tsukasaJapan9/inchworm_robot/stl/inchworm_body.stl

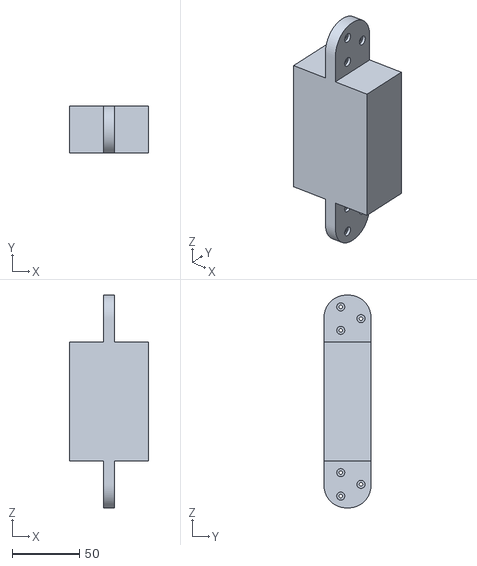
[picture p1: CAD file, 2026-10-27]
stl/inchworm_body.stl
58.4 x 35.0 x 157.8
