tsukasaJapan9/inchworm_robot/stl/inchworm_leg.stl

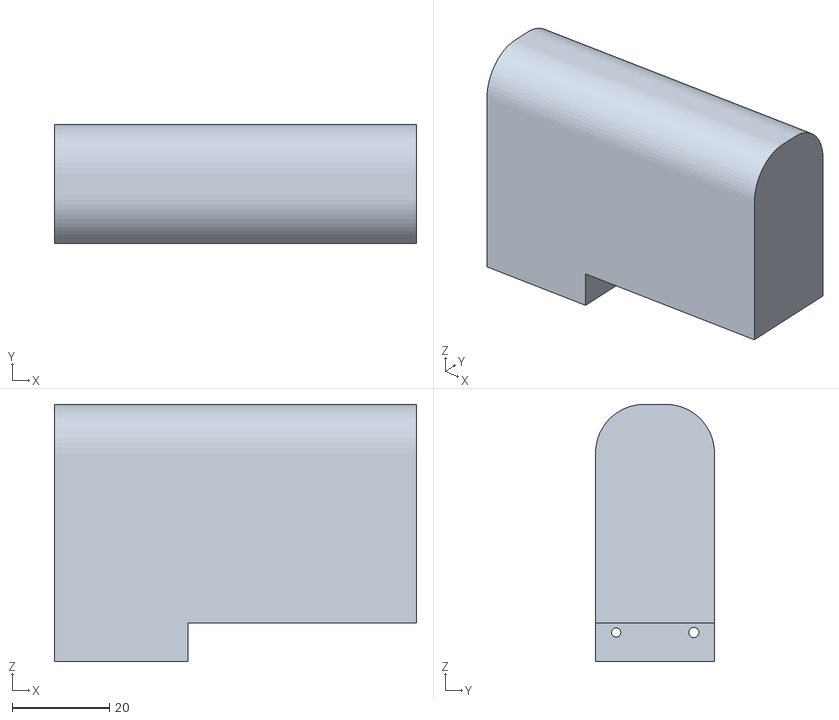
[picture p2: CAD file, 2026-10-27]
stl/inchworm_leg.stl
74.6 x 24.5 x 53.0
