tsukasaJapan9/inchworm_robot/firmware/include/policy_weights_best.h

// ppo_raw_s0 から自動生成。手で編集しないこと。
// 生成: export_policy.py
//
// 方策: 14 -> Tanh(64) -> Tanh(64) -> 2（決定論的に平均を使う）
// 観測の並び:
//   [0:3]   重力方向（機体座標・単位ベクトル）
//   [3:6]   角速度 [rad/s]（機体座標）
//   [6:8]   関節角 q1, q2 [rad]（水平が 0、持ち上げる向きが正）
//   [8:10]  関節角速度 [rad/s]
//   [10:12] 前回の行動（[-1,1]）
//   [12:14] いまの目標角 / 90deg
// 行動: 目標角の増分。a * 5.0deg を毎制御ステップ積分する

#pragma once

#define POLICY_N_IN 14
#define POLICY_N_HIDDEN 64
#define POLICY_N_OUT 2
#define POLICY_DELTA_MAX_DEG 5.0000f
#define POLICY_Q_MAX_DEG 90.0f
#define POLICY_CLIP_OBS 10.0f
#define POLICY_CTRL_HZ 100

static const float kObsMean[14] = {
    +0.00000000e+00f, +0.00000000e+00f, +0.00000000e+00f, +0.00000000e+00f,
    +0.00000000e+00f, +0.00000000e+00f, -5.91512382e-01f, -4.76291269e-01f,
    -4.85463068e-02f, +1.17681306e-02f, -5.83386198e-02f, -4.46531288e-02f,
    -4.03800994e-01f, -3.29097480e-01f};

static const float kObsStd[14] = {
    +1.00000000e+00f, +1.00000000e+00f, +1.00000000e+00f, +1.00000000e+00f,
    +1.00000000e+00f, +1.00000000e+00f, +6.33301079e-01f, +6.48618698e-01f,
    +7.84442616e+00f, +7.57599163e+00f, +9.62690532e-01f, +9.31985021e-01f,
    +4.01620507e-01f, +4.12158936e-01f};

static const float kW0[896] = {
    -1.24998808e-01f, -3.48368287e-01f, +2.54038721e-03f, -5.79545721e-02f,
    +1.56321332e-01f, -2.43111193e-01f, +6.03758514e-01f, -1.51515573e-01f,
    -1.73486724e-01f, -1.02083594e-01f, +9.16817114e-02f, -5.17216809e-02f,
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
    +1.09459020e-01f, -3.47710736e-02f, -1.53051883e-01f, +1.21875972e-01f,
    +1.44052774e-01f, -1.64233685e-01f, -1.15037046e-01f, -2.70267487e-01f,
    -1.04568750e-02f, -1.31727621e-01f, +2.78664418e-02f, -3.38132158e-02f,
    -1.33103892e-01f, -7.86769539e-02f, -1.07549906e-01f, -1.26556888e-01f,
    +6.03140779e-02f, +1.45445287e-01f, -1.31578997e-01f, +1.09187342e-01f,
    -5.55461319e-03f, -1.35907263e-01f, -1.05529487e-01f, +1.73909307e-01f,
    -3.03140935e-02f, +2.09814636e-03f, -6.65227026e-02f, +2.42546108e-02f,
    +9.35731530e-02f, -1.61508769e-01f, +1.27376122e-02f, -8.76836106e-02f,
    +5.12226252e-03f, -6.48401603e-02f, +1.70342416e-01f, +1.41291348e-02f,
    +5.56773618e-02f, -6.68664202e-02f, -2.03340709e-01f, +1.12306334e-01f,
    -1.22746937e-01f, -1.50332242e-01f, -1.55354798e-01f, +2.31487021e-01f,
    +1.61886454e-01f, -7.67782237e-03f, +1.92244679e-01f, -7.43495300e-02f,
    +1.60949409e-01f, +5.49658425e-02f, +3.69816162e-02f, -3.58987004e-02f,
    -5.55724055e-02f, -2.86081079e-02f, -1.68594837e-01f, -2.54996703e-03f};

static const float kB2[2] = {+3.69302463e-03f, -1.19649647e-02f};
