tsukasaJapan9/inchworm_robot/(commit log)

2026-10-27 ロボットのソースコード一式を追加
2026-10-27 stlデータを追加 (#2)
    [inchworm_body.stl, inchworm_leg.stl]
